TheRealMolen/subharmolizer/subharmolizer-rev3.png

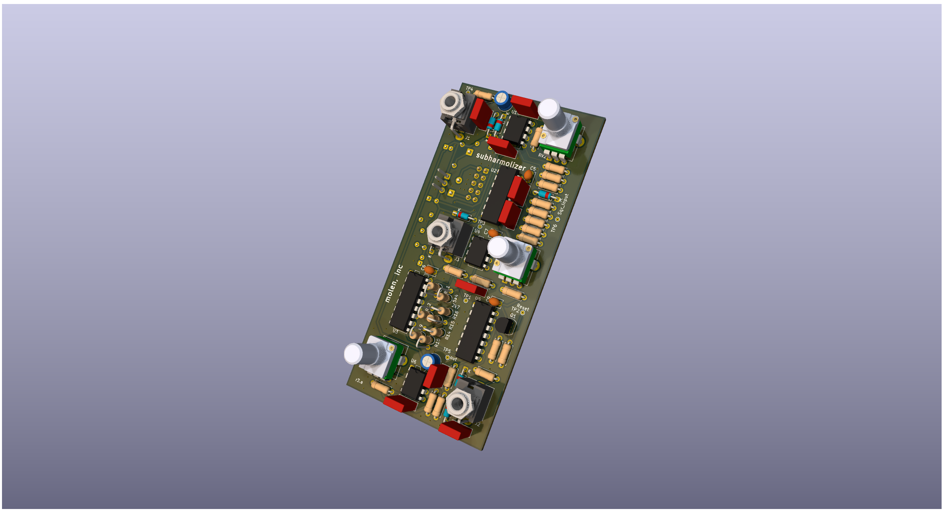
subharmolizer-rev3.png
