TheRealMolen/subharmolizer/schematic_rev3.pdf

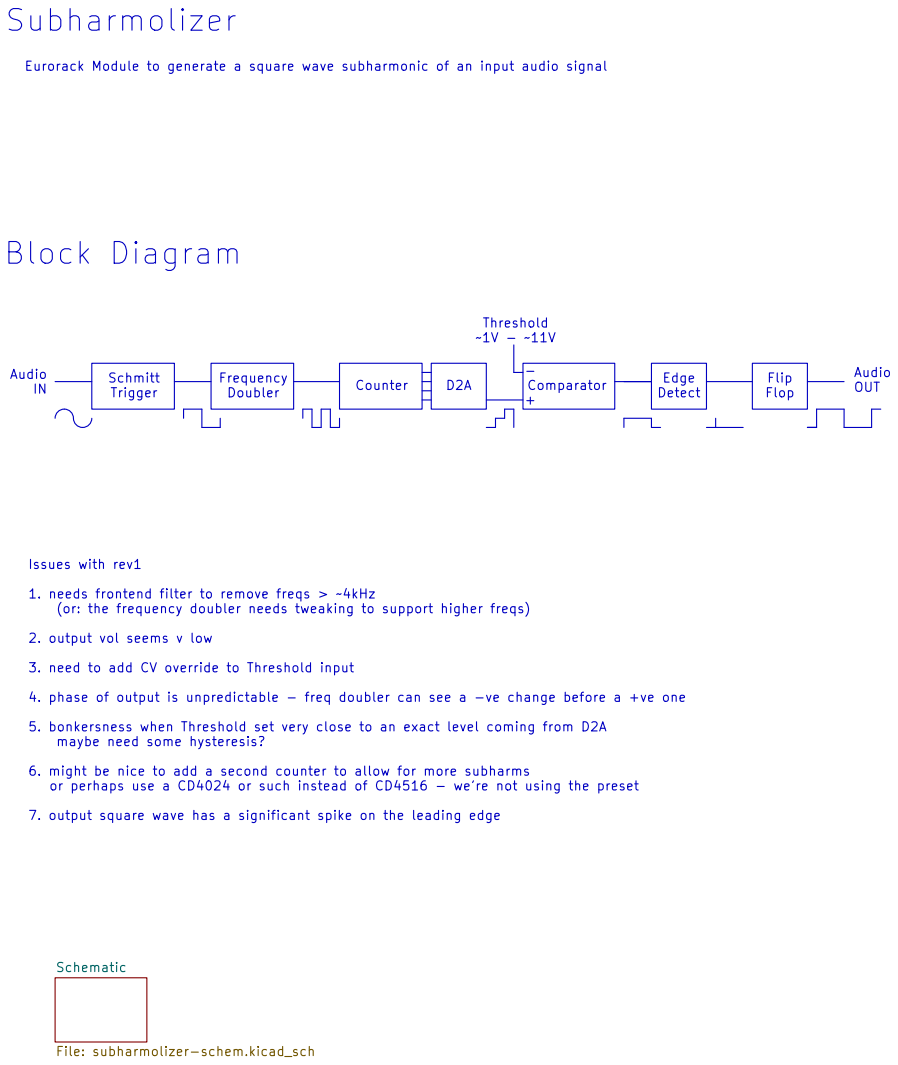
[picture p2: page 1]

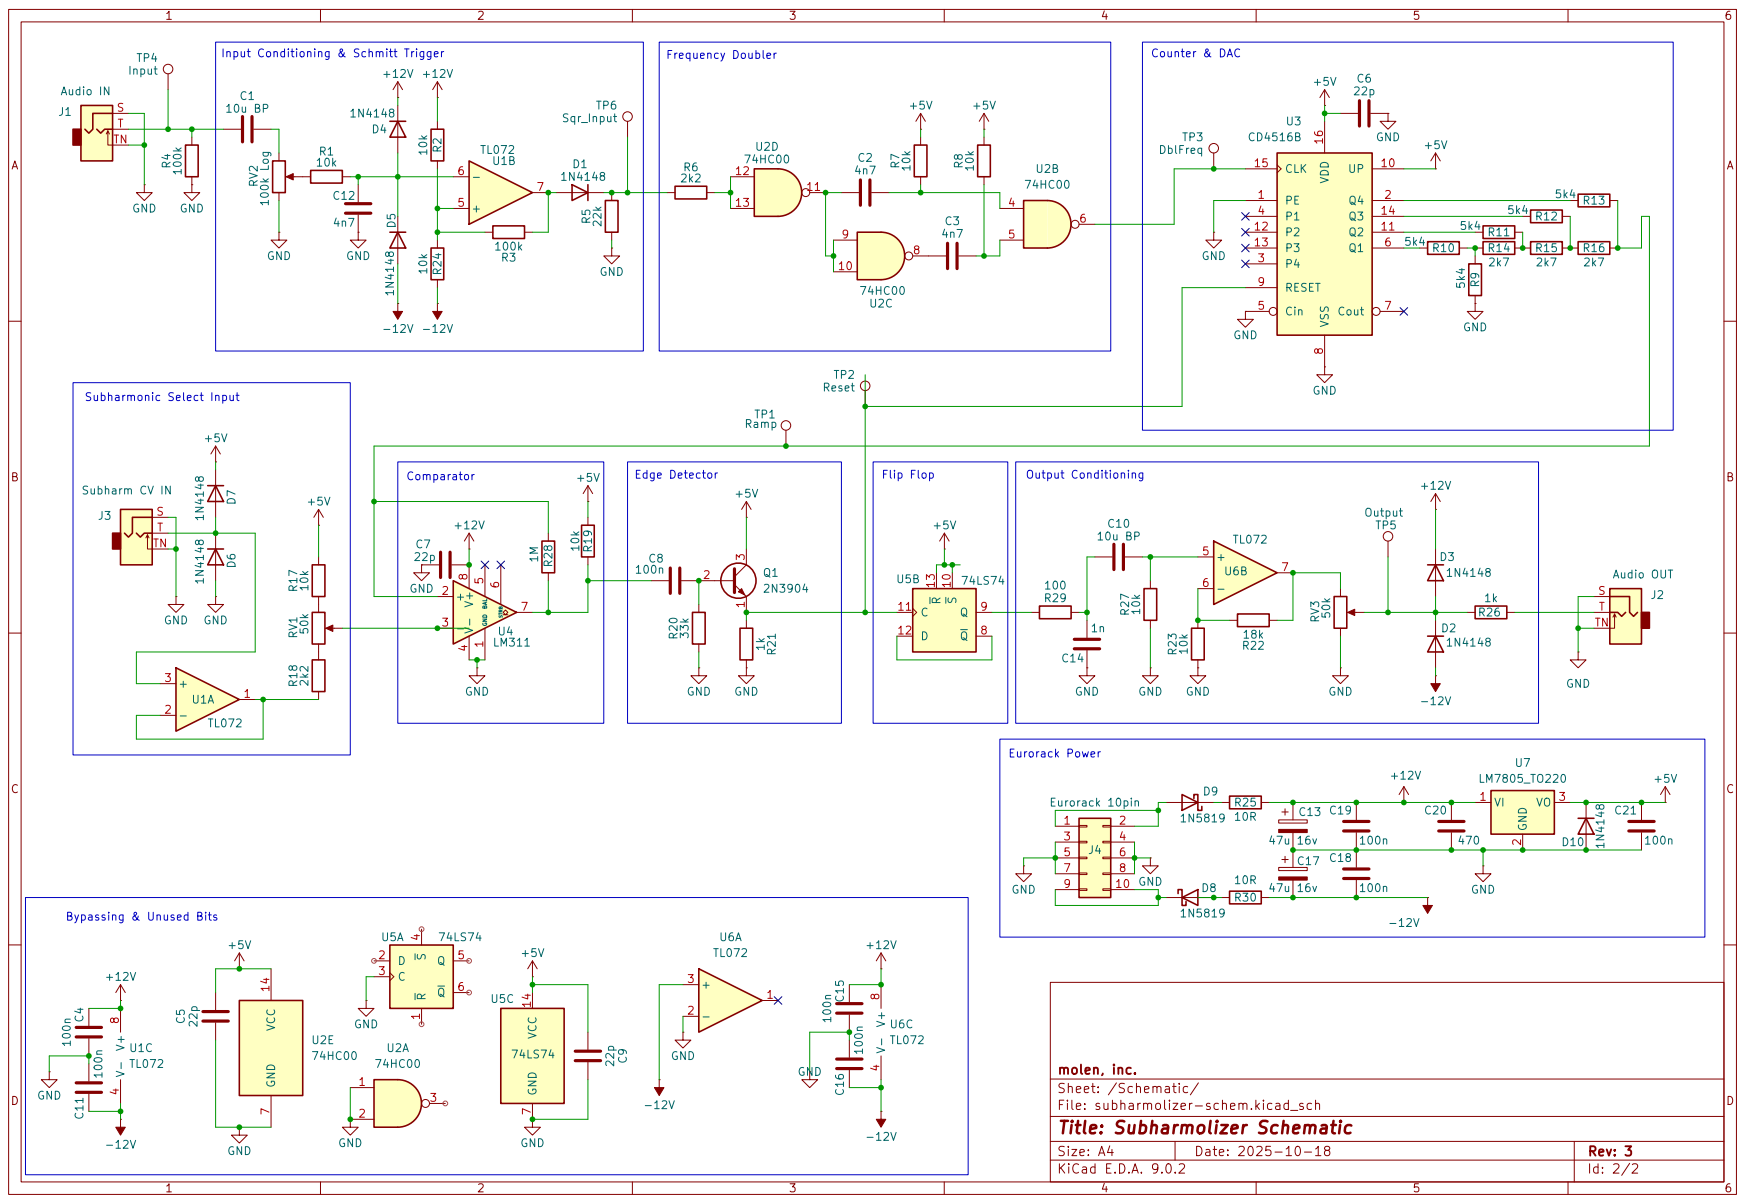
[picture p3: page 2]
