TheRealMolen/subharmolizer/schematic_rev2.pdf

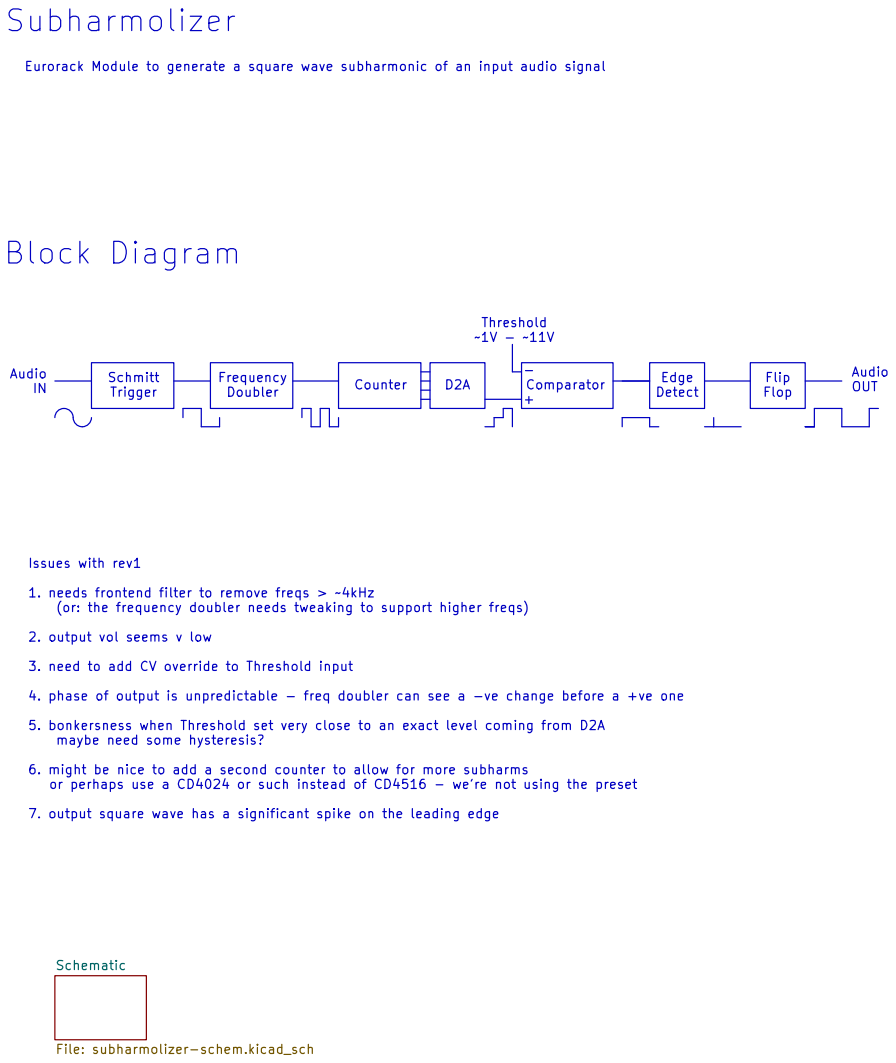
[picture p4: page 1]

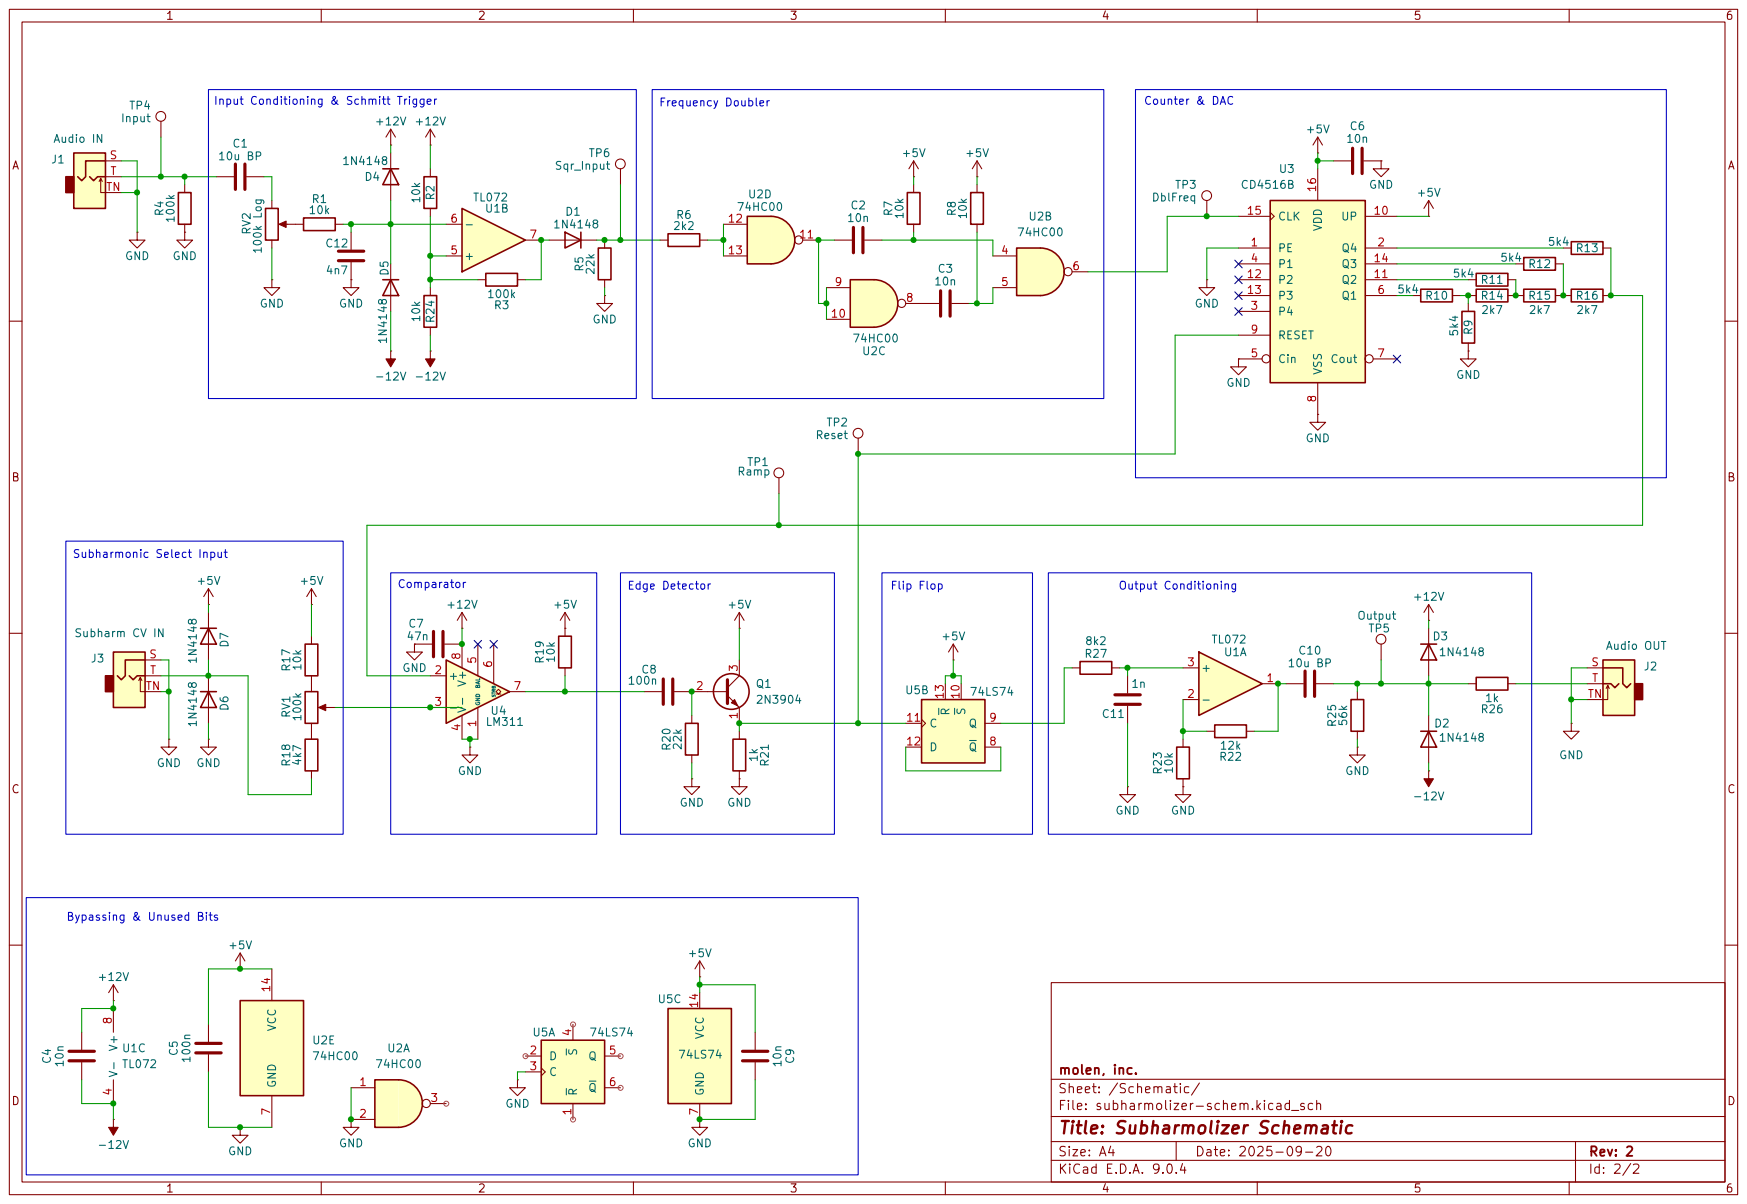
[picture p5: page 2]
