TheRealMolen/subharmolizer/schematic_rev1.pdf

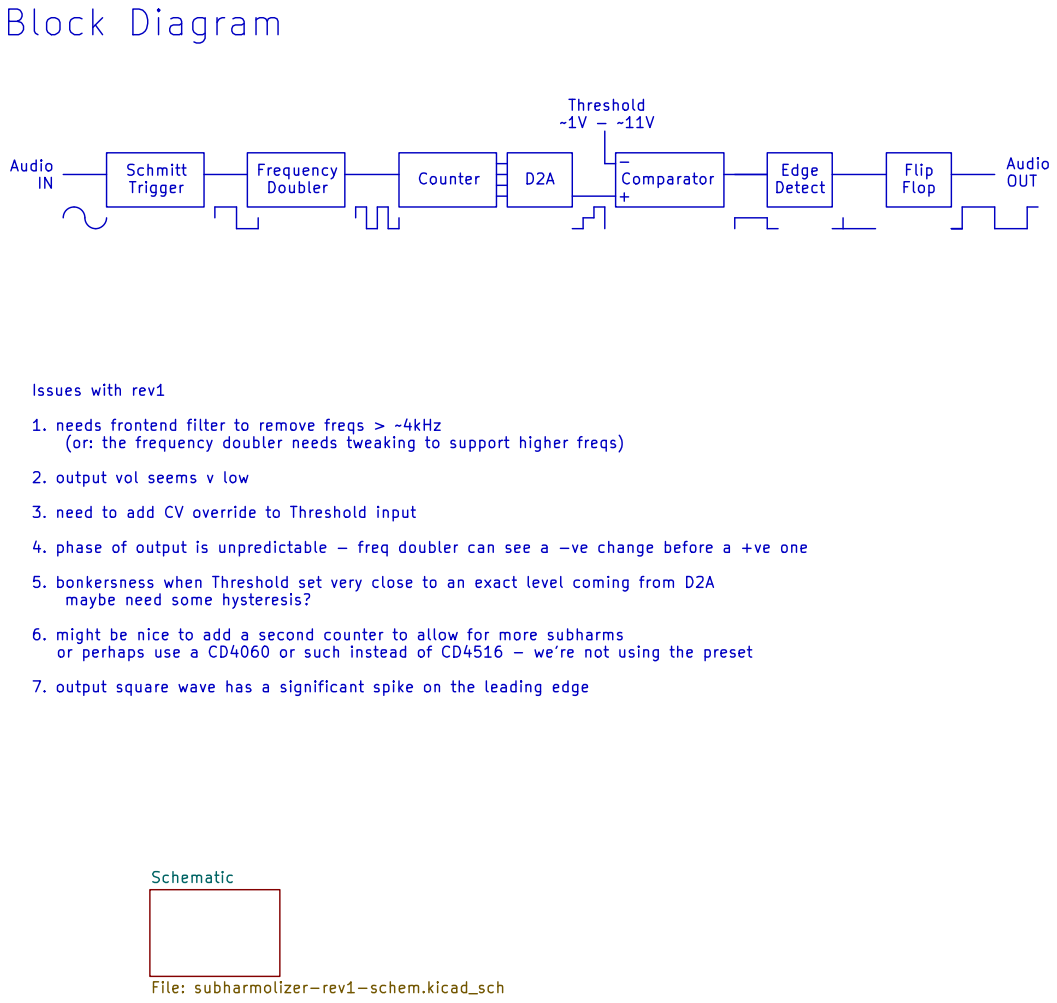
[picture p6: page 1]

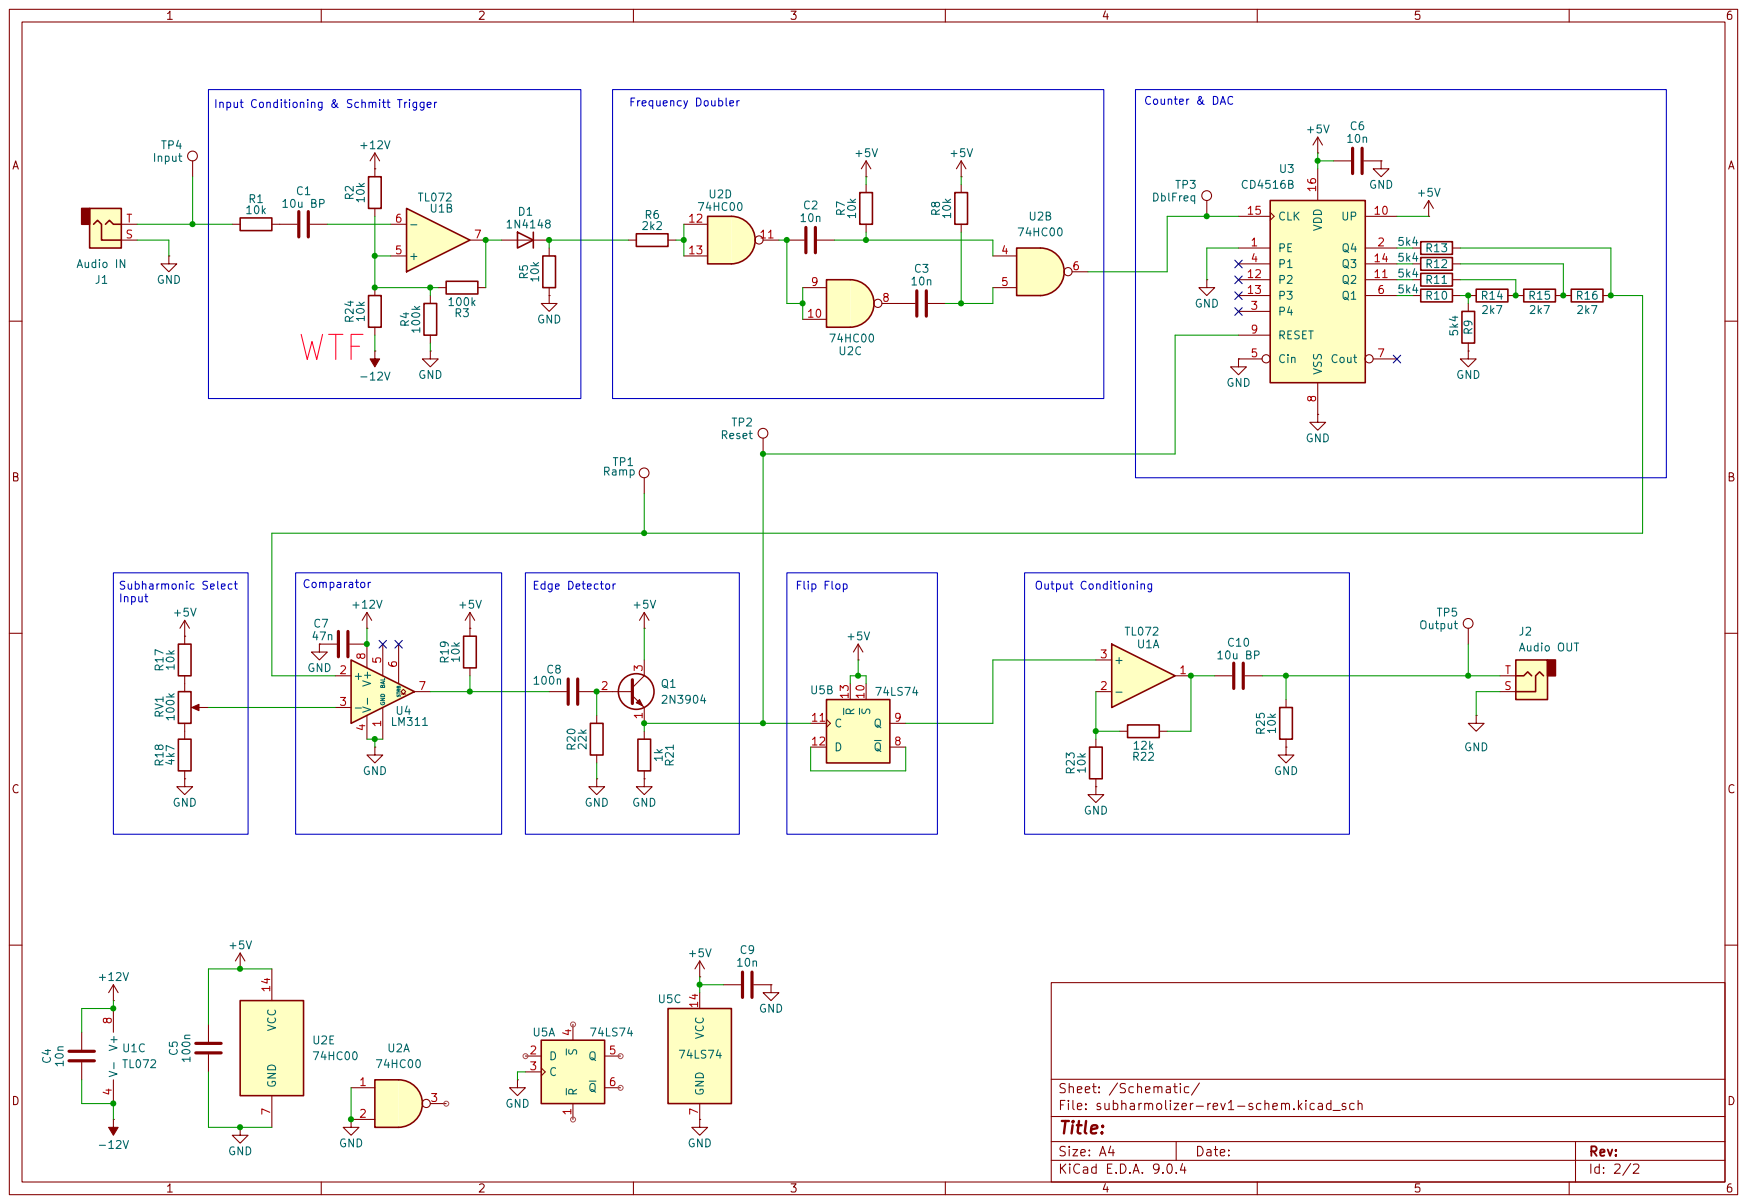
[picture p7: page 2]
