TheRealMolen/subharmolizer/subharmolizer-rev3/subharmolizer-rev3.kicad_pcb

## KiCad design subharmolizer-rev3/subharmolizer-rev3.kicad_pcb (2025-10-19)

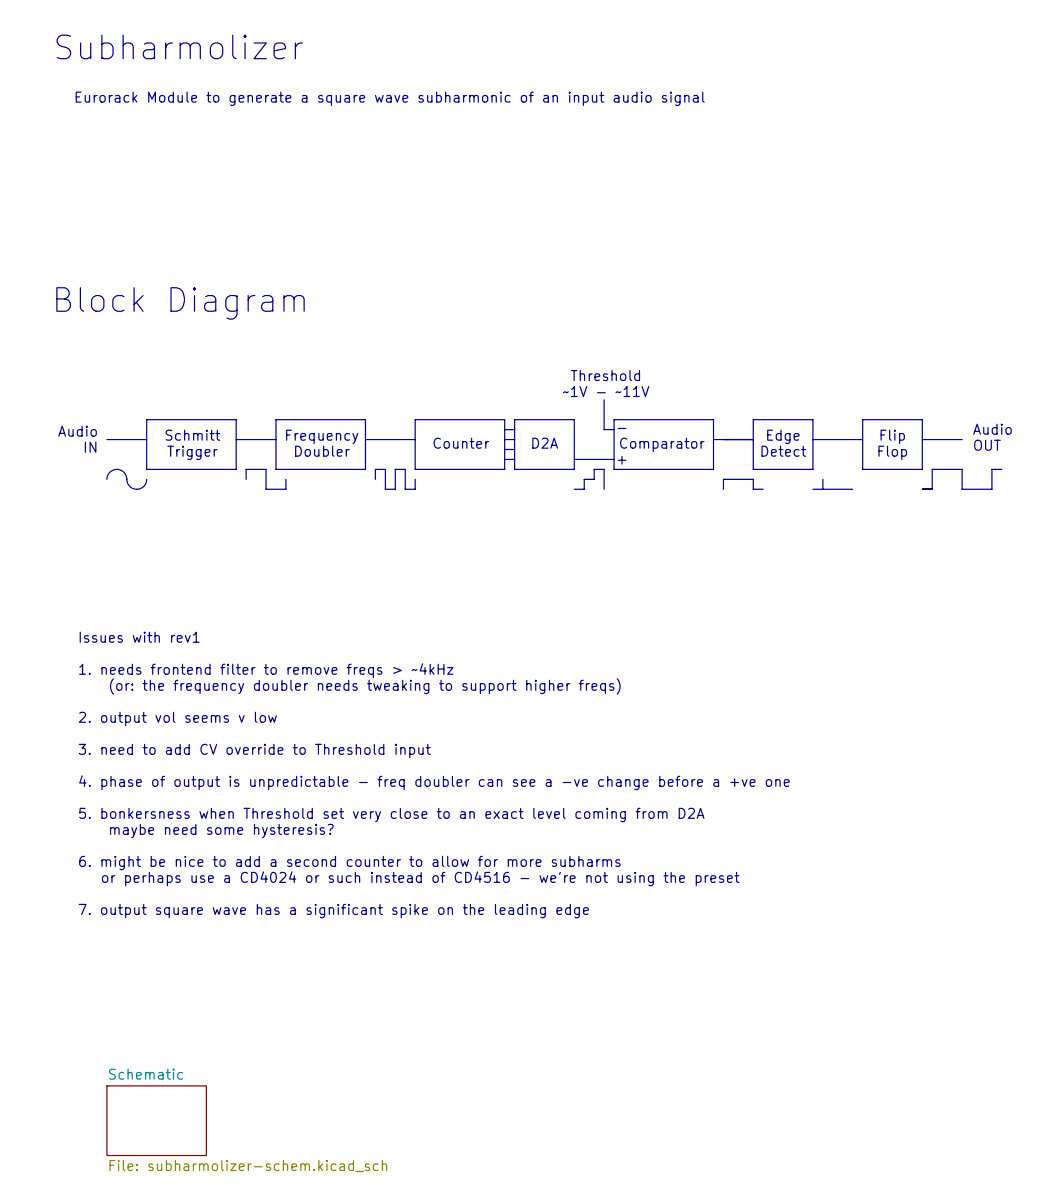
[picture p8: schematic subharmolizer-rev3.kicad_sch, Subharmolizer Overview]

Notes on the sheet:
Schmitt Trigger
Edge Detect
Block Diagram
Flip Flop
Threshold ~1V - ~11V
Subharmolizer
Audio IN
Issues with rev1 1. needs frontend filter to remove freqs > ~4kHz (or: the frequency doubler needs tweaking to support higher freqs) 2. output vol seems v low 3. need to add CV override to Threshold input 4. phase of output is unpredictable - freq doubler can see a -ve change before a +ve one 5. bo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
D2A
Comparator
Frequency Doubler
Counter
Eurorack Module to generate a square wave subharmonic of an input audio signal
Audio OUT

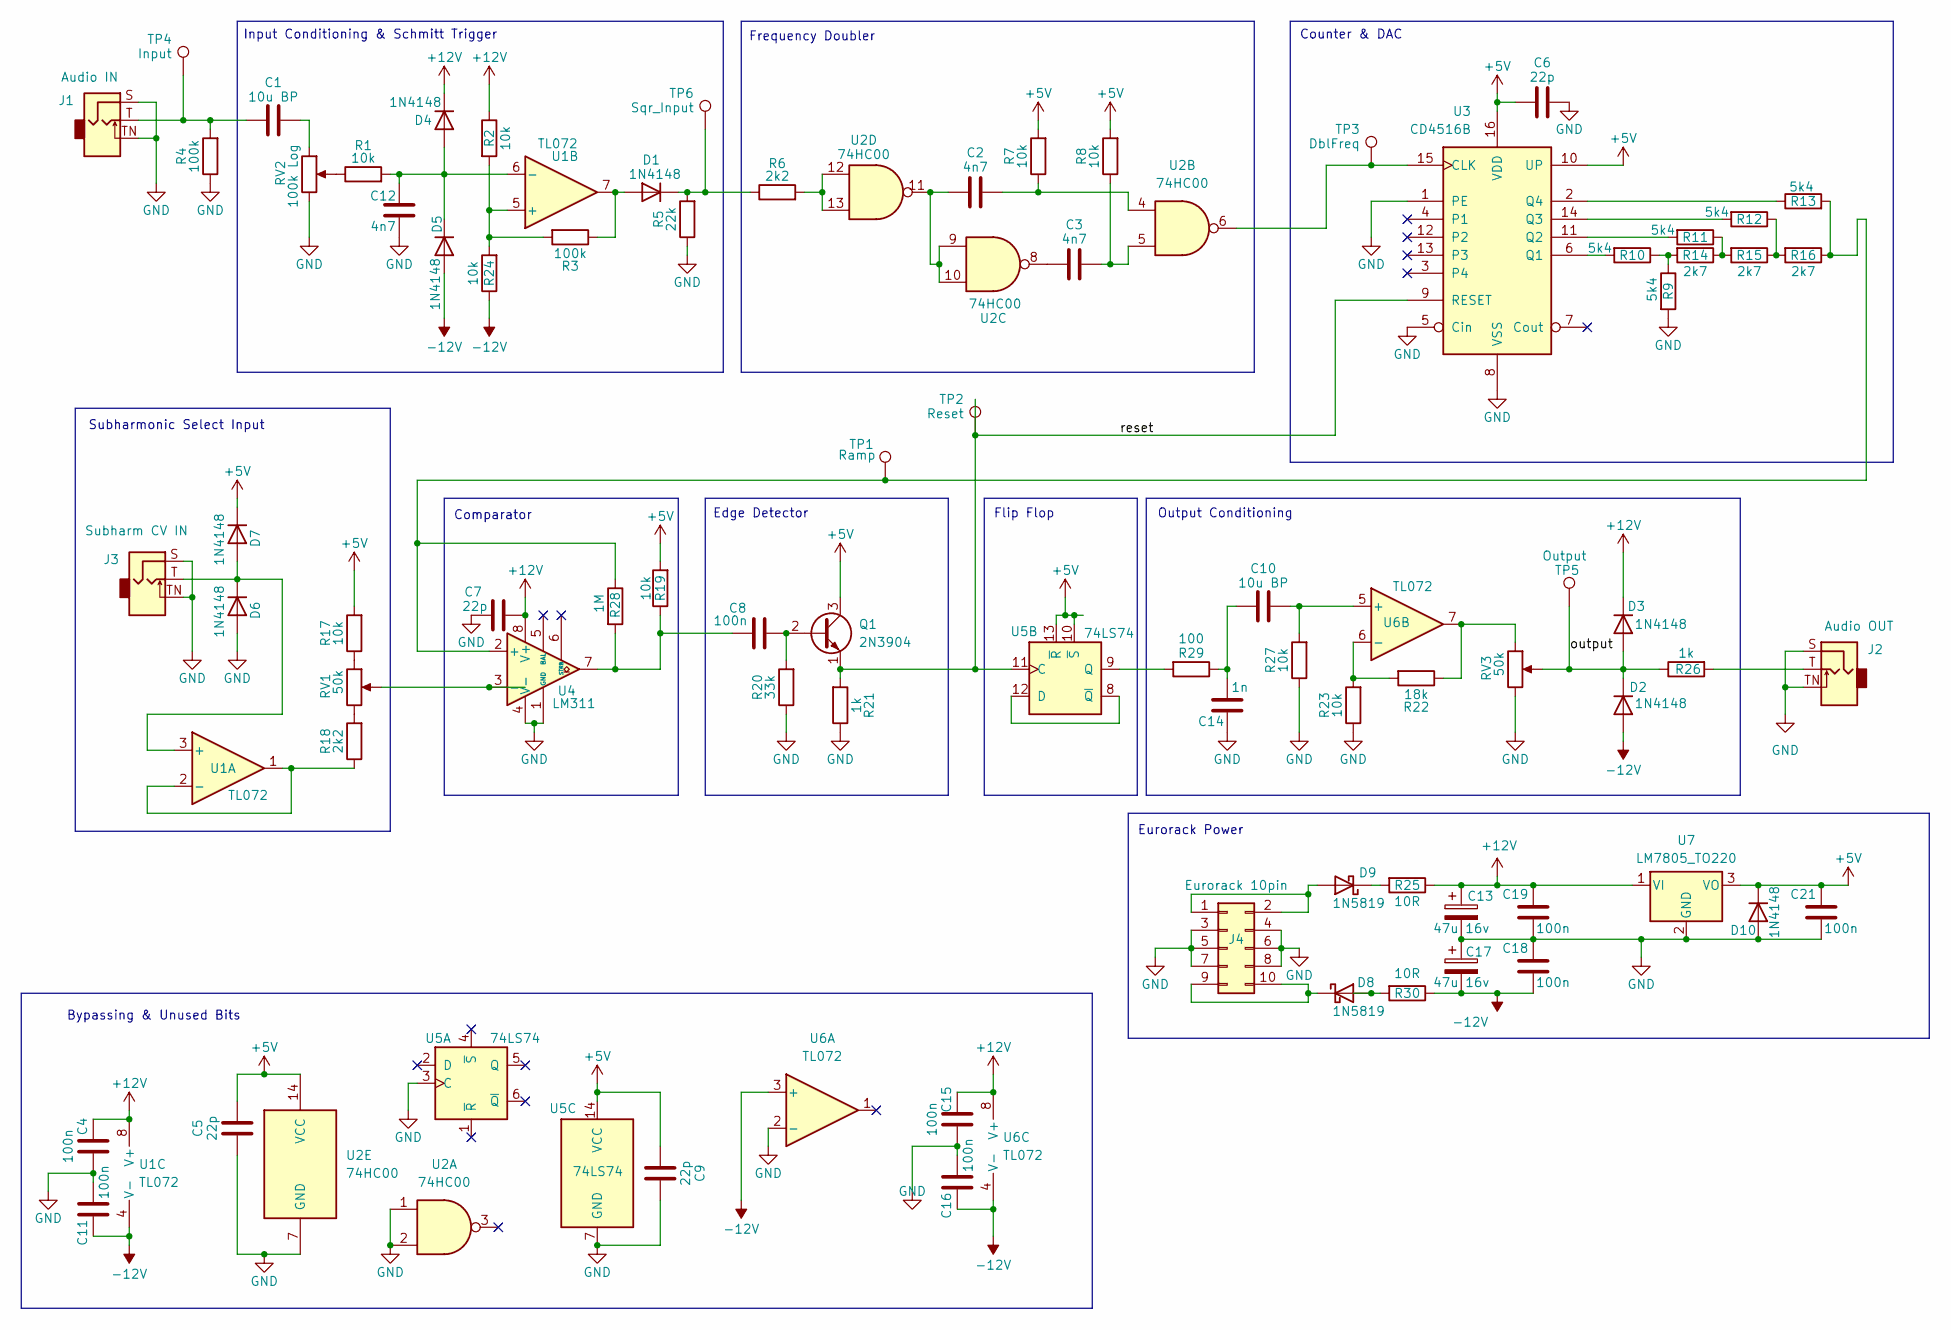
[picture p9: schematic subharmolizer-schem.kicad_sch, Subharmolizer Schematic]

Parts:
C1, C10: 10u BP; C_Radial_D5.0mm_H5.0mm_P2.00mm
C2, C3, C12: 4n7; C_Rect_L7.0mm_W2.5mm_P5.00mm
C4, C8, C11, C15, C16, C18, C19, C21: 100n; C_Rect_L7.0mm_W2.5mm_P5.00mm
C5, C6, C7, C9: 22p; C_Disc_D3.8mm_W2.6mm_P2.50mm
C13, C17: 47u 16v; CP_Radial_D5.0mm_P2.00mm
C14: 1n; C_Rect_L7.0mm_W2.5mm_P5.00mm
D1, D2, D3, D4, D5, D6, D7, D10: 1N4148; D_DO-35_SOD27_P7.62mm_Horizontal
D8, D9: 1N5819; D_DO-41_SOD81_P10.16mm_Horizontal
J1: Audio IN; Jack_3.5mm_QingPu_WQP-PJ398SM_Vertical
J2: Audio OUT; Jack_3.5mm_QingPu_WQP-PJ398SM_Vertical
J3: Subharm CV IN; Jack_3.5mm_QingPu_WQP-PJ398SM_Vertical
J4: Eurorack 10pin; IDC-Header_2x05_P2.54mm_Vertical
Q1: 2N3904; TO-92_Inline
R1, R2, R7, R8, R17, R19, R23, R24, R27: 10k; R_Axial_DIN0207_L6.3mm_D2.5mm_P7.62mm_Horizontal
R3, R4: 100k; R_Axial_DIN0207_L6.3mm_D2.5mm_P7.62mm_Horizontal
R5: 22k; R_Axial_DIN0207_L6.3mm_D2.5mm_P7.62mm_Horizontal
R6, R18: 2k2; R_Axial_DIN0207_L6.3mm_D2.5mm_P7.62mm_Horizontal
R9, R10, R11, R12, R13: 5k4; R_Axial_DIN0207_L6.3mm_D2.5mm_P2.54mm_Vertical
R14, R15, R16: 2k7; R_Axial_DIN0207_L6.3mm_D2.5mm_P2.54mm_Vertical
R20: 33k; R_Axial_DIN0207_L6.3mm_D2.5mm_P7.62mm_Horizontal
R21, R26: 1k; R_Axial_DIN0207_L6.3mm_D2.5mm_P7.62mm_Horizontal
R22: 18k; R_Axial_DIN0207_L6.3mm_D2.5mm_P7.62mm_Horizontal
R25, R30: 10R; R_Axial_DIN0207_L6.3mm_D2.5mm_P7.62mm_Horizontal
R28: 1M; R_Axial_DIN0207_L6.3mm_D2.5mm_P7.62mm_Horizontal
R29: 100; R_Axial_DIN0207_L6.3mm_D2.5mm_P7.62mm_Horizontal
RV1, RV3: 50k; Potentiometer_Alpha_RD901F-40-00D_Single_Vertical_CircularH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
RV2: 100k Log; Potentiometer_Alpha_RD901F-40-00D_Single_Vertical_CircularH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
TP1: Ramp; TestPoint_THTPad_D1.0mm_Drill0.5mm
TP2: Reset; TestPoint_THTPad_D1.0mm_Drill0.5mm
TP3: DblFreq; TestPoint_THTPad_D1.0mm_Drill0.5mm
TP4: Input; TestPoint_THTPad_D1.0mm_Drill0.5mm
TP5: Output; TestPoint_THTPad_D1.0mm_Drill0.5mm
TP6: Sqr_Input; TestPoint_THTPad_D1.0mm_Drill0.5mm
U1, U6: TL072; DIP-8_W7.62mm
U2: 74HC00; DIP-14_W7.62mm
U3: CD4516B; DIP-16_W7.62mm
U4: LM311; DIP-8_W7.62mm
U5: 74LS74; DIP-14_W7.62mm
U7: LM7805_TO220; TO-220-3_Vertical

Connections:
+5V: C5.2, C6.1, C9.1, C21.2, D7.1 (K), D10.1 (K), Q1.3 (C), R7.2, R8.2, R17.2, R19.2, U2.14 (VCC), U3.10 (UP), U3.16 (VDD), U5.10 (~S), U5.13 (~R), U5.14 (VCC), U7.3 (VO)
+12V: C4.2, C7.1, C13.1, C15.2, C19.2, D3.1 (K), D4.1 (K), R2.1, R25.1, U1.8 (V+), U4.8 (V+), U6.8 (V+), U7.1 (VI)
-12V: C11.1, C16.1, C17.2, C18.1, D2.2 (A), D5.2 (A), R24.1, R30.1, U1.4 (V-), U6.3 (+), U6.4 (V-)
/Schematic/output: D2.1 (K), D3.2 (A), R26.1, RV3.2, TP5.1
/Schematic/reset: Q1.1 (E), R21.2, TP2.1, U3.9 (RESET), U5.11 (C)
GND: C4.1, C5.1, C6.2, C7.2, C9.2, C11.2, C12.1, C13.2, C14.1, C15.1, C16.2, C17.1, C18.2, C19.1, C21.1, D6.2 (A), D10.2 (A), J1.S, J1.TN, J2.S, J2.TN, J3.S, J3.TN, J4.3, J4.4, J4.5, J4.6, J4.7, J4.8, R4.1, R5.1, R9.2, R20.1, R21.1, R23.1, R27.1, RV2.3, RV3.3, U2.1, U2.2, U2.7 (GND), U3.1 (PE), U3.5 (Cin), U3.8 (VSS), U4.1 (GND), U4.4 (V-), U5.3 (C), U5.7 (GND), U6.2 (-), U7.2 (GND)
unnamed: C1.1, J1.T, R4.2, TP4.1
unnamed: C1.2, RV2.1
unnamed: C2.1, U2.9, U2.10, U2.11
unnamed: C2.2, R7.1, U2.4
unnamed: C3.1, U2.8
unnamed: C3.2, R8.1, U2.5
unnamed: C8.2, R19.1, R28.2, U4.7
unnamed: C10.1, C14.2, R29.1
unnamed: D1.2 (A), R3.1, U1.7
unnamed: D1.1 (K), R5.2, R6.1, TP6.1
unnamed: C12.2, D4.2 (A), D5.1 (K), R1.2, U1.6 (-)
unnamed: D6.1 (K), D7.2 (A), J3.T, U1.3 (+)
unnamed: D8.2 (A), R30.2
unnamed: D8.1 (K), J4.9, J4.10
unnamed: D9.2 (A), J4.1, J4.2
unnamed: D9.1 (K), R25.2
unnamed: J2.T, R26.2
unnamed: C8.1, Q1.2 (B), R20.2
unnamed: R1.1, RV2.2
unnamed: R6.2, U2.12, U2.13
unnamed: R9.1, R10.1, R14.2
unnamed: R11.1, R14.1, R15.2
unnamed: R12.1, R15.1, R16.2
unnamed: R17.1, RV1.1
unnamed: R18.2, RV1.3
unnamed: R22.1, RV3.1, U6.7
unnamed: R18.1, U1.1, U1.2 (-)
unnamed: R2.2, R3.2, R24.2, U1.5 (+)
unnamed: TP3.1, U2.6, U3.15 (CLK)
unnamed: R10.2, U3.6 (Q1)
unnamed: R11.2, U3.11 (Q2)
unnamed: R12.2, U3.14 (Q3)
unnamed: R13.1, U3.2 (Q4)
unnamed: R13.2, R16.1, R28.1, TP1.1, U4.2 (+)
unnamed: RV1.2, U4.3 (-)
unnamed: U5.8 (~Q), U5.12 (D)
unnamed: R29.2, U5.9 (Q)
unnamed: C10.2, R27.2, U6.5 (+)
unnamed: R22.2, R23.2, U6.6 (-)

Notes on the sheet:
Bypassing & Unused Bits
Eurorack Power
Frequency Doubler
Counter & DAC
Edge Detector
Input Conditioning & Schmitt Trigger
Flip Flop
Output Conditioning
Comparator
Subharmonic Select Input

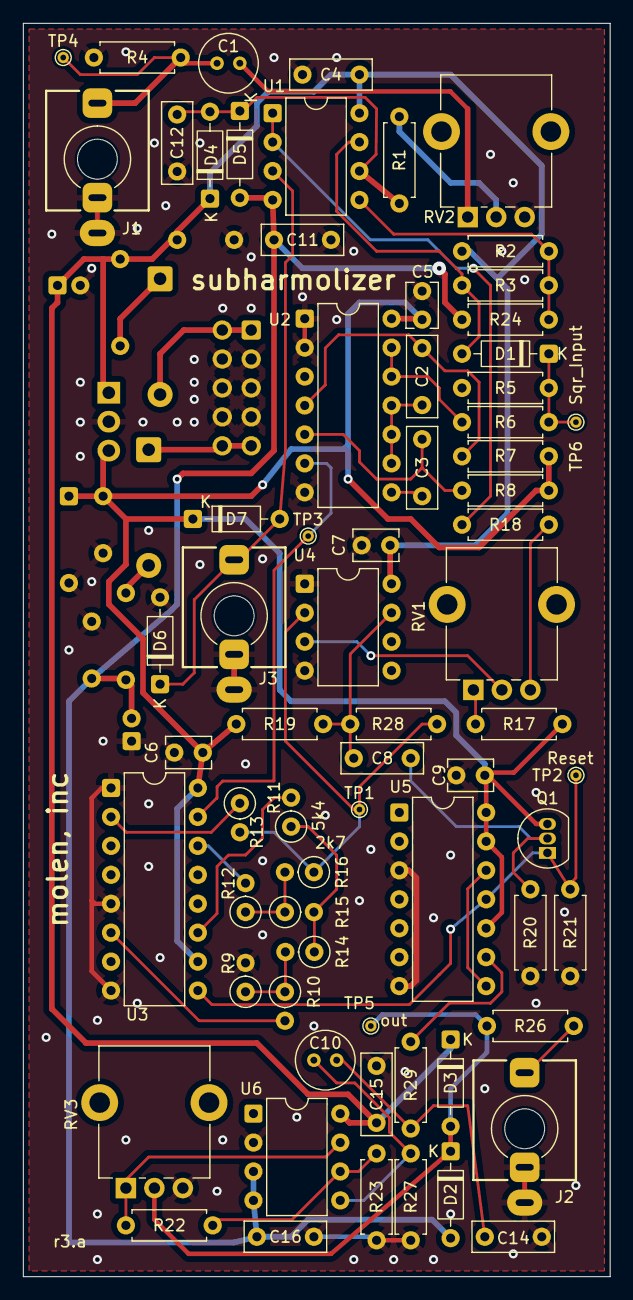
[picture p10: board subharmolizer-rev3.kicad_pcb from above]

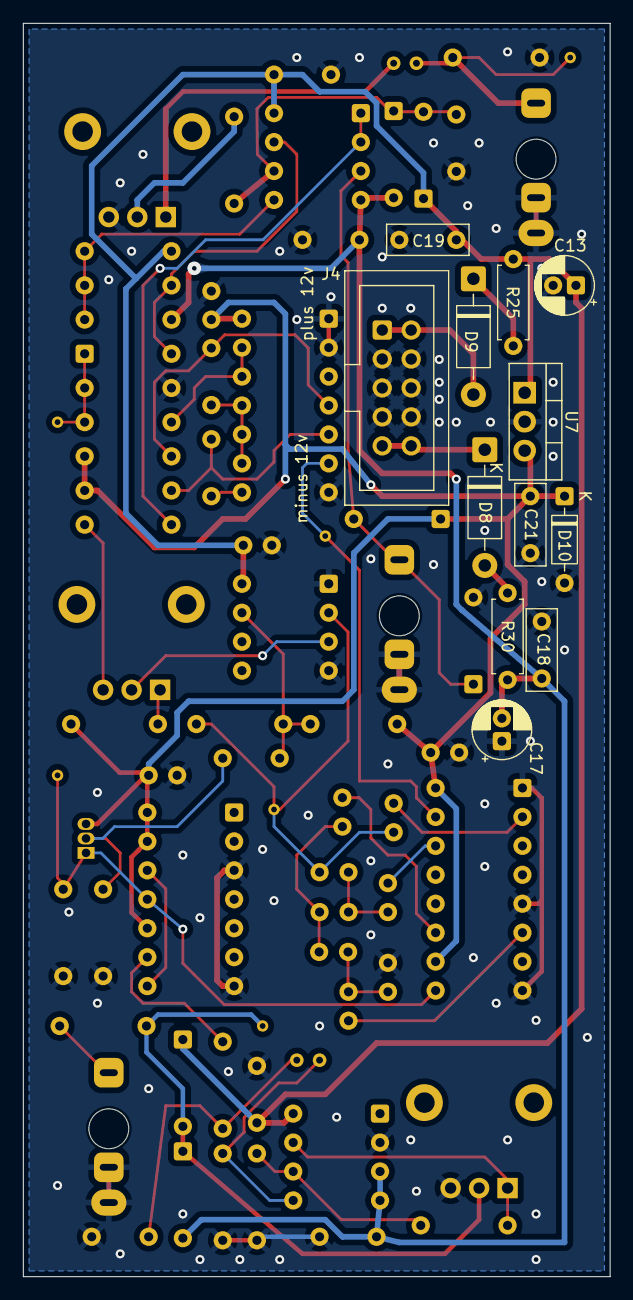
[picture p11: board subharmolizer-rev3.kicad_pcb from below]

Board: 2 copper layers, 51.5 x 110.0 mm, 81 parts (12 on the bottom side), 45 nets.
