TheRealMolen/subharmolizer/(commit log)

2025-09-20 rev2 tweaks
    [subharmolizer-rev2.kicad_sch, subharmolizer-schem.kicad_sch]
2025-10-19 rev3 & work towards pcb
2025-10-19 rev3.a pcb fully routed and ready for fab
    [subharmolizer-rev3.kicad_pcb, subharmolizer-rev3.kicad_sch, subharmolizer-schem.kicad_sch]
